ImproverX/PK-6128c_PP/README.md

# Вектор ПК-6128ц++
Вектор ПК-6128ц новодел на базе [восстановленной схемы](https://github.com/ImproverX/PK-6128c). Электронная часть выполнена на трёх платах: процессора, памяти и основной платы, соединяющихся между собой через угловые двухрядные штырьевые разъёмы. Предусмотрена установка двух внутренних плат расширения, например, [квази-дисков](/KVAZI_DISK/). Платы выполнены в размере под установку в обычный [корпус ПК Вектор-06ц](https://github.com/ImproverX/Vector06c_case), в качестве клавиатуры используется [плата под ПКМ-1Б или кнопки Черри](https://github.com/ImproverX/Vector-KBD), либо оригинальная клавиатура от Вектора, блок питания -- внешний от Вектора, либо любой на 5В и 1А (минимум).<br>Обсуждение в [форуме zx-pk.ru](https://zx-pk.ru/threads/34716-reinkarnatsiya-vektor-pk-6128ts.html).

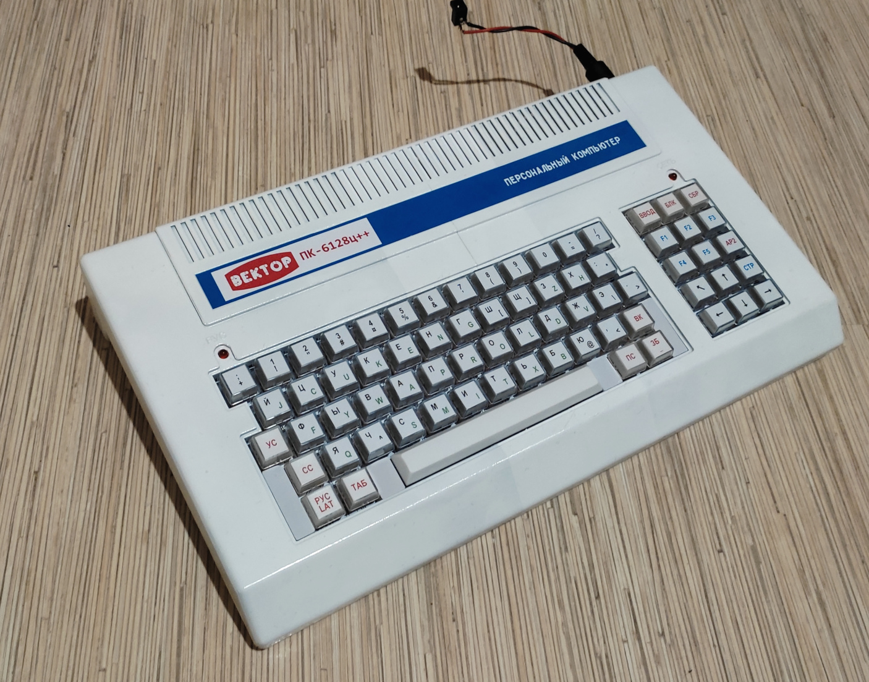
[picture p1: Photo.jpg]
P0


## Содержимое проекта
* [PK6128c_PP.DSN](/PK6128c_PP.DSN) -- обновлённая схема ПК-6128ц++ в формате Proteus 7. В данном ПО возможно частичное моделирование работы схемы. Для корректного открытия схемы потребуется содержимое ПЗУ D10 (К155РЕ3) в бинарном виде [K155RE3.bin](/K155PE3.bin) и модель [K155RE3.MDF](https://github.com/ImproverX/PK-6128c/blob/main/K155PE3.MDF) (положите этот файл в "<директория протеуса>\MODELS" для работы моделирования D10 в схеме).
* [PK6128c_PP.LYT](/PK6128c_PP.LYT) -- разводка плат в формате Proteus 7.
* [PK6128c_PP_Shema_P1.png](/PK6128c_PP_Shema_P1.png) и [PK6128c_PP_Shema_P2.png](/PK6128c_PP_Shema_P2.png) -- схема в формате PNG, страница 1 и страница 2.
* [PK6128c_PP_cpu - CADCAM.ZIP](/PK6128c_PP_cpu%20-%20CADCAM.ZIP), [PK6128c_PP_ram - CADCAM.ZIP](/PK6128c_PP_ram%20-%20CADCAM.ZIP) и [PK6128c_PP_main - CADCAM.ZIP](/PK6128c_PP_main%20-%20CADCAM.ZIP) -- гербер-архивы для изготовления плат процессора, памяти и основной платы соответственно.
* [K155RE3n.bin](/K155PE3n.bin) -- прошивка для ПЗУ D10, оптимизированная для ПК-6128ц++, с постоянным округлением команд до кратности 4 тактам (рекомендуется). [K155RE3.bin](/K155PE3.bin) -- та же прошивка, но с кратностью "2 такта" торможения работы процессора при выводе бордюра и КСИ/ССИ, даёт небольшое ускорение, но возможны глюки. Оба варианта описаны в файле [K155PE3.txt](/K155PE3.txt).
* [ROM](/ROM/) -- прошивка для ПК-6128ц++.
* [Joysticks.png](/Joysticks.png) -- подключение джойстиков.
* [KVAZI_DISK](/KVAZI_DISK/) -- внутренний квази-диск для ПК-6128ц++ на 512кБ (2х256кБ), совместим с МДОС, в том числе [Т-72](https://github.com/ImproverX/MDOS_T-72) и [РДС](https://github.com/ImproverX/RDS), работает на портах 10h и 11h. Схема, разводка и гербер-архив для изготовления платы.
* [HDD](/HDD/) -- внутренний контроллер накопителя на жёстких магнитных дисках (НЖМД, или HDD), программно совместим с МДОС и РДС. В качестве НЖМД могут использоваться различные SSD-IDE диски (например, DiskOnModule), а также переходники на CF и CD-карты. Также отдельно разведена плата с разъёмом для CF-карт вместо IDE.

Нумерация элементов оригинального ПК-6128ц по возможности сохранена, добавленные микросхемы на схеме обозначены U**, резисторы от R200 и далее, конденсаторы от C100 и далее.

## Примечания по сборке ПК-6128ц++

Резисторы R3 и R216 возможно потребуется подобрать под кварц для стабильной генерации частоты, их номинал может варироваться от 500 Ом до 4,8 кОм, следует выбирать среднее значение.

В случае установки YM2149F вместо AY-3-8910 резистор R223 следует увеличить до 8,2 кОм для выравнивания громкости с ВИ53.

Дроссель L1 нужно выбирать на ток не меньше 800 мА.

Кварц Q2 (4,433619 МГц) следует выбирать с максимальной доступной точностью, иначе возможны пропадания цвета при передаче сигнала PAL.

Кварц Q3 (7,0936 МГц или 3,5468 МГц) можно заменить близким по номиналу, +/- 100кГц. Но при этом следует учесть, что тональность звука на AY-3-8910 будет пропорционально выше или ниже. Например, при установке кварца на 7,1 МГц нота ЛЯ вместо 440 Гц будет звучать на 440,4 Гц (+0,09%).

Кварц Q4 (32,768 кГц) следует выбирать с характеристикой нагрузочной емкости 6 пФ, иначе точность часов будет неудовлетворительной.

В остальном, при исправных деталях и качественной пайке, ПК-6128ц++ в настройке не нуждается и начинает работать сразу.

## Изменения по отношению к оригинальной схеме ПК-6128ц

* Заменил память на SRAM. Сейчас это сделать проще, чем искать РУ5. Память осталась на 16 бит при чтении видеоданных с задержкой на триггере, как было сделано изначально в ПК-6128. 
* Заменил ПЗУ РФ4А на 64кб 29EE512. Переключение доступа к страницам ПЗУ программное, для этого используется стандартная переключалка области экрана ПК-6128 на порту 0Dh. При отправленном нуле в нулевом бите в этот порт будет подключена область ПЗУ 8000h-FFFFh (по умолчанию при сбросе), при единице -- область 0000h-7FFFh.
* Убрал из схемы сетевую карту. Как оказалось, в некоторых экземплярах ПК-6128ц она не была распаяна, да и в современных реалиях она становится совершенно бесполезной. 
* Убрал контроллер дисковода -- при внешнем подключении не имеет значения, есть ли в ПК встроенный контроллер, если он подключается вместе с флоповодом.
* Заменил все чипы КМОП серий К561 и К1561 на ТТЛ. Кроме того это позволило убрать из схемы несколько резисторов и конденсаторов, требующихся для совмещения уровней сигналов КМОП и ТТЛ.
* Сделал видеовыход на CXA2075, в том числе:
  * Сделал инверсию цвета, исправил строчные синхроимпульсы (ССИ) и выровнял по центру изображение.
  * Немного изменил схему формирования сигнала кадровых синхроимпульсов (КСИ) -- вместо объединения КСИ и ССИ через "исключающее или" использовал свободный триггер.
  * Сделал гасящий синхроимпульс (ГСИ), во время кадра он на ~5мкс длиннее ССИ, и на всю длительность КСИ гасит сигнал.
  * Заменил резисторный видео-ЦАП на чип SDA7123, что существенно улучшило качество картинки.
* Изменил схему записи палитры -- в схеме ПК6128 микросхемы РУ2 были открыты всегда, кроме некоторого времени перед КСИ и в конце КСИ. Теперь РУ2, при отсутствии сигнала записи в порт 0Ch, будут отключаться при ГСИ. Кроме того, при нажатии на БЛК-СБР теперь экран не засвечивается белым, как было на ПК-6128ц, а гасится.
* Исправил схему работы экрана в режиме 256х512, теоретически получается так: по даташитам задержка на 74ALS00 (D14:A) равна 3..11 (2..8) нс, на 74ALS32 (U10:C) -- 2..14 (3..12) нс, т.е. разница при худшем варианте характеристик деталей должна быть не больше 5 нс при ширине пикселя 83 нс в режиме 512. На реале разница практически не заметна.
* Изменил схему подключения джойстиков -- на ПК6128 был свой вариант, программно несовместимый с существующими на Векторе. Сделал также, как на "Векторе-06ц.02", плюс аппаратно совместимыми с [джойстиками Atari/MSX](https://www.msx.org/wiki/Joystick/joypad_controller), на разъёмах D9 (как com-порт). Есть возможность использовать [джойстики от Sega](https://eax.me/arduino-sega-controller/) (только указатель направления и кнопки В и С). Для подключения к плате используется стандартный провод для COM-порта, подробнее -- [см. тут](/Joysticks.png).
* Добавил в схему стандартный Векторовский порт ВУ -- с ним можно будет подключать существующее внешнее Векторовское железо, например, тот же комбодевайс. Сигнал СТЕК там формируется по типу адаптеров Z80 для Вектора, он будет подан при командах PUSH, POP и XTHL, чего вполне достаточно для работы КД. Единственно, на этом ВУ не будут работать старые квази-диски, т.к. новая схема не вырабатывает сигналы регенерации памяти.
* Добавил внутренний динамик и AY-3-8910. Выход AY подключён по методу Саттарова В., но только микшируется в моно.
* Добавил часы RTC на DS12885, подключение выполнено по [омской схеме](https://caglrc.cc/scalar/ware/519/) для Вектора, с учётом документации на DS12885.
* D25 заменил на 74HC138 и U24 на 74hc139 -- чипы 74HC155 и аналогичные в исполнении SMD почему-то сложно найти в продаже.
* Разделил схему на платы в соответствии с предложенной [концепцией](https://zx-pk.ru/threads/34546-quot-vektor-pk-6128ts-quot-khotelos-by-uznat-pobolshe.html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). Элементы на схеме с фоном из жёлтой штриховки ушли на плату ОЗУ, с голубой штриховкой -- ЦПУ.
* Для сокращения числа контактов между платами внедрил одну из своих прошлых идей, сделал "эмуляцию" ВВ55 на логических элементах U28 и U29, что позволило сократить число линий на 8+5-3=10 шт. И теперь независимо от того, какая конфигурация загружена в ВВ55 на порту 00, запись в порт 03 будет устанавливать сдвиг экрана, запись в порт 02 -- цвет бордюра и режим 512/256. В дополнение, для полного соответствия работе ВВ55, запись в порт 00 конфигурации приводит к обнулению значений в портах 02 и 03, для выключения обнуления портов можно разомкнуть перемычку JP2.
* Решил использовать ПЗУ D10 на все 100%, для этого вывод А4 переключил с земли на сигнал LD0, теперь во время показа бордюров и КСИ/ССИ из неё будет использоваться вторая половина адресов, с 16 по 31. Это даёт то, что теперь можно будет разрешить процессору доступ к памяти тогда, когда не считываются данные для графики. Прирост быстродействия при этом будет максимум процентов на 5, если не ошибаюсь, но при этом будет неравномерная скорость процессора, что в некоторой степени влияет на обмен с магнитофоном, а также на другие процедуры, зависимые от времени выполнения команд процессора. Для обеспечения равномерной скорости ЦПУ рекомендуется использовать прошивку [K155RE3n.bin](/K155PE3n.bin).
* Добавил подтягивающие резисторы на шину данных -- теперь при чтении из неподключённых портов возвращается код FFh.

## Порты внутренних устройств ПК-6128ц++

* 00..03 -- Управление D80 (ВВ55А): клавиатура, режимы экрана, магнитофон.
* 04..07 -- Порт ПУ D78 (ВВ55А)
* 08..0B -- Таймер D79 (ВИ53)
* 0C -- Запись цвета в D54, D55 (РУ2)
* 0D -- Установка номера банка ОЗУ для экрана
* 0E -- Установка режимов диспетчера памяти / Чтение состояния Джойстика 2
* 0F -- Сброс системы / Чтение состояния джойстика 1
* 10 -- Запись конфигурации Квази-Диска 1
* 11 -- Запись конфигурации Квази-Диска 2
* 12, 13 -- (не используется)
* 14, 15 -- Управление синтезатором U22 (AY-3-8910)
* 16..1F -- (не используется)
* 20, 21 -- Управление часами U34 (DS12885S)
* 22..4F -- (не используется)
* 50..58, 5F -- контроллер НЖМД (IDE HDD)
* 59..5E, 60..FF -- (не используется)

## ...

Фотография внутренностей собранного ПК-6128ц++:<br>
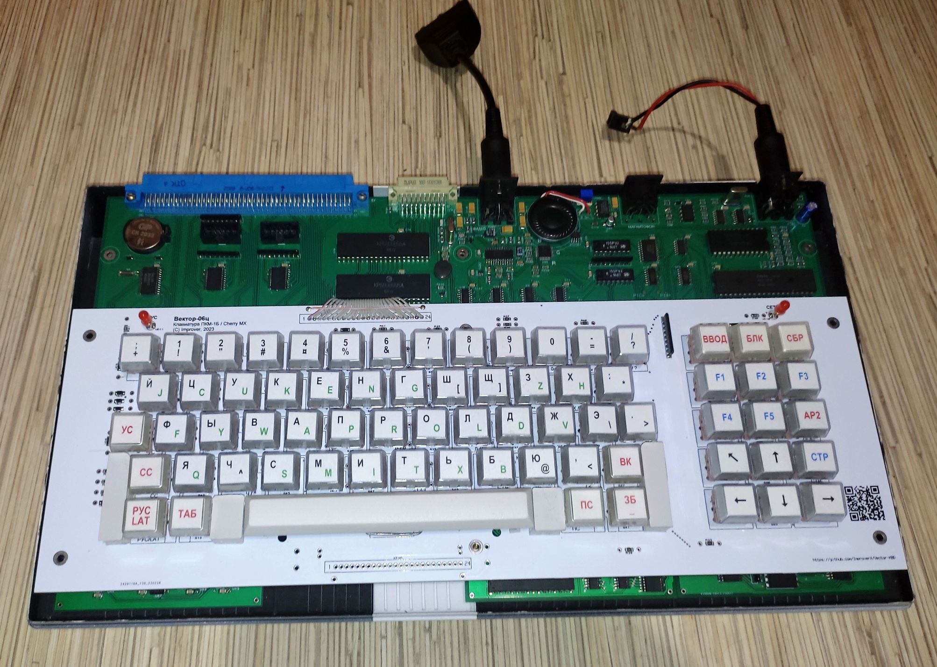
[picture p2: Photo1.jpg]
P3
<br><br>
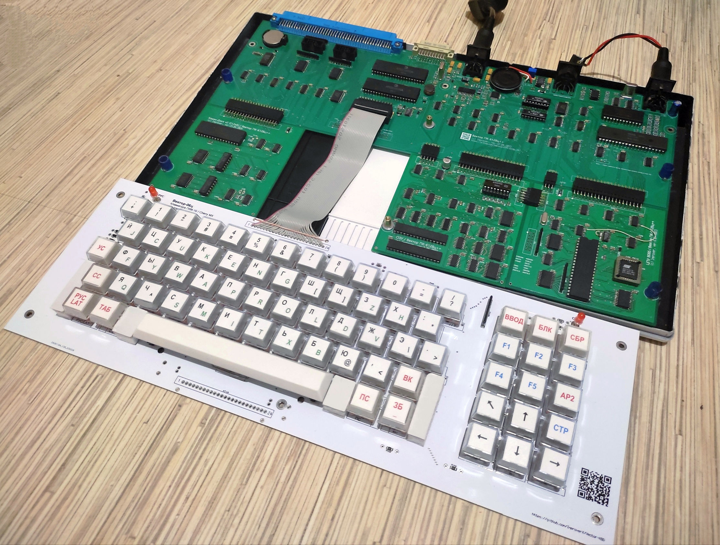
[picture p3: Photo2.jpg]
P4
<br><br>

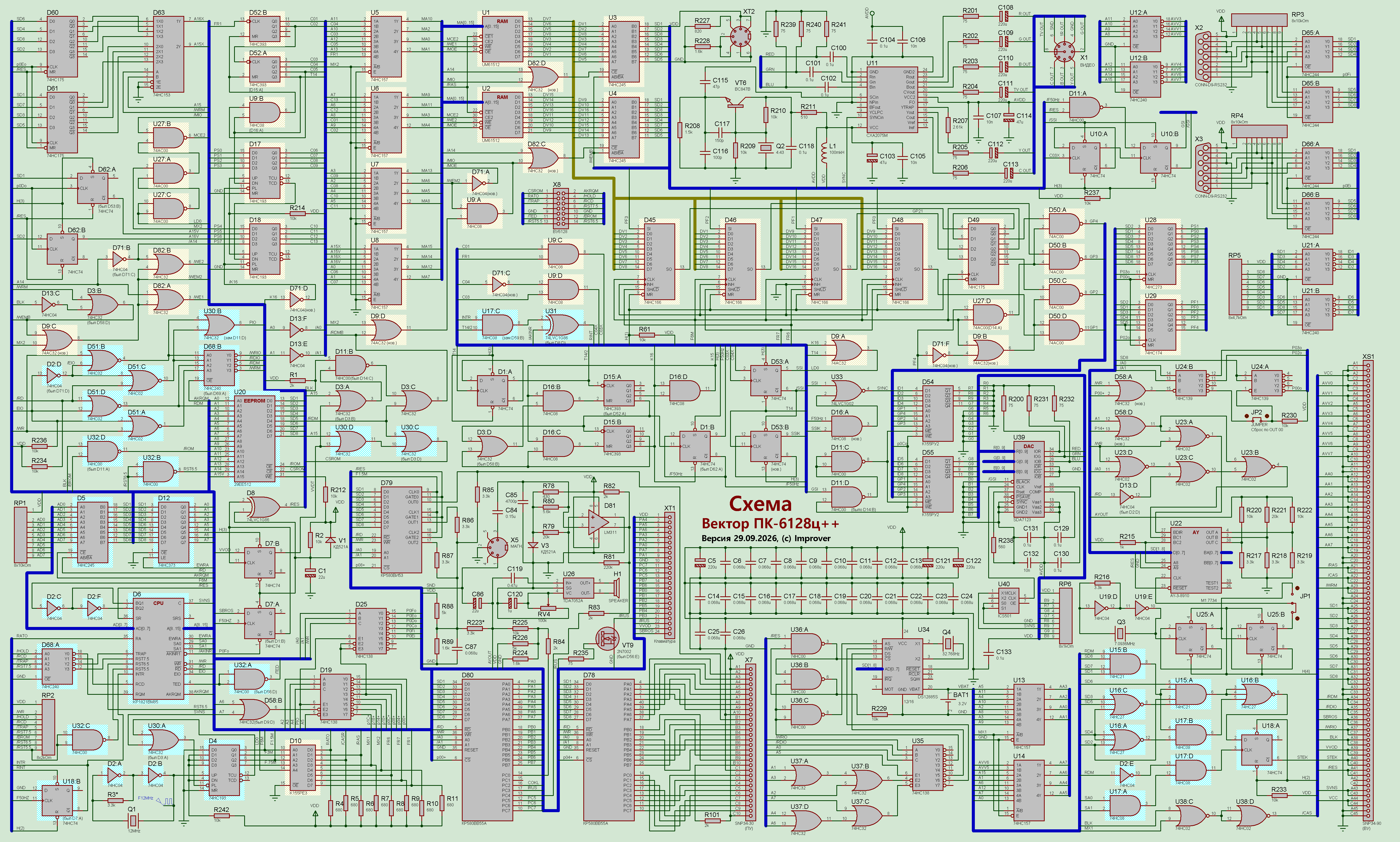
[picture p4: PK6128c_PP_Shema_P1.png]
P1
<br>
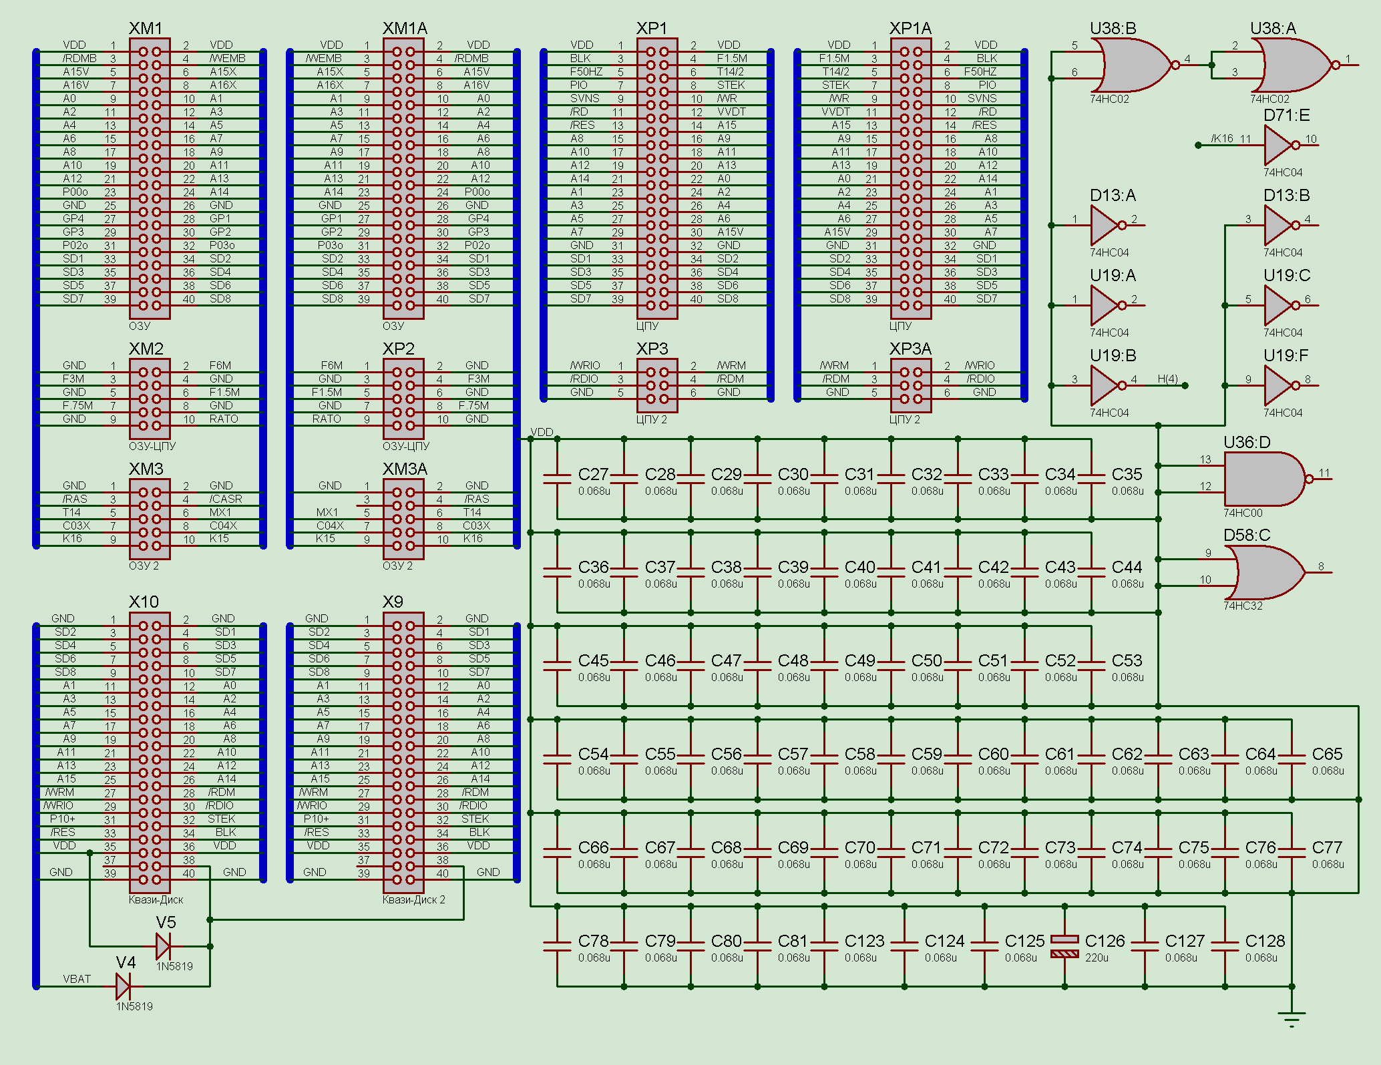
[picture p5: PK6128c_PP_Shema_P2.png]
P2
