ImproverX/PK-6128c_PP/GAL-RE3/README.md

# Замена К155РЕ3 на GAL16V8B

На место D10 (К155РЕ3) можно установить GAL16V8B. Схема подключения и фото установки:

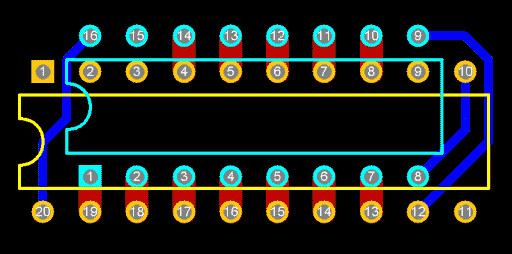
[picture p6: GAL-RE3/GAL2RE3.png]
P1


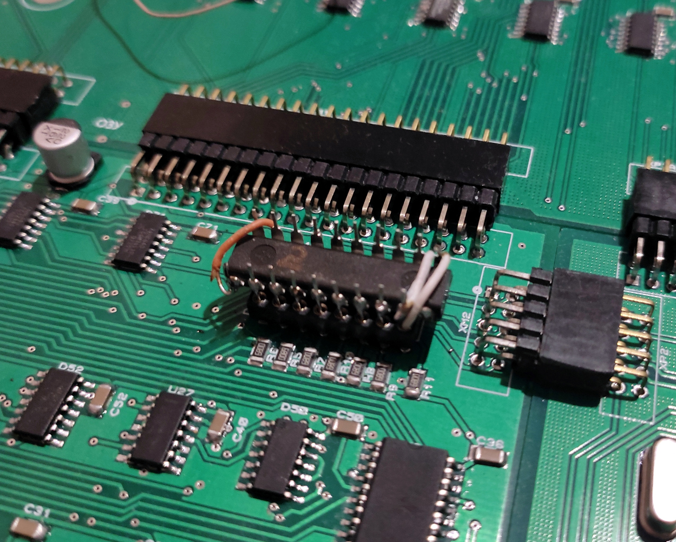
[picture p7: GAL-RE3/GAL2RE3.jpg]
P2


## Прошивка
* [RE3_N.jed](/GAL-RE3/RE3_N.jed) -- обычный режим работы памяти, исходники [RE3_N.pld](/GAL-RE3/RE3_N.PLD) и [RE3_N.si](/GAL-RE3/RE3_N.SI)
* [RE3__.jed](/GAL-RE3/RE3__.jed) -- ускоренный режим работы памяти, исходники [RE3__.pld](/GAL-RE3/RE3__.PLD) и [RE3__.si](/GAL-RE3/RE3__.SI)
