ImproverX/PK-6128c_PP/HDD/README.md

# Контроллер НЖМД для ПК-6128ц++

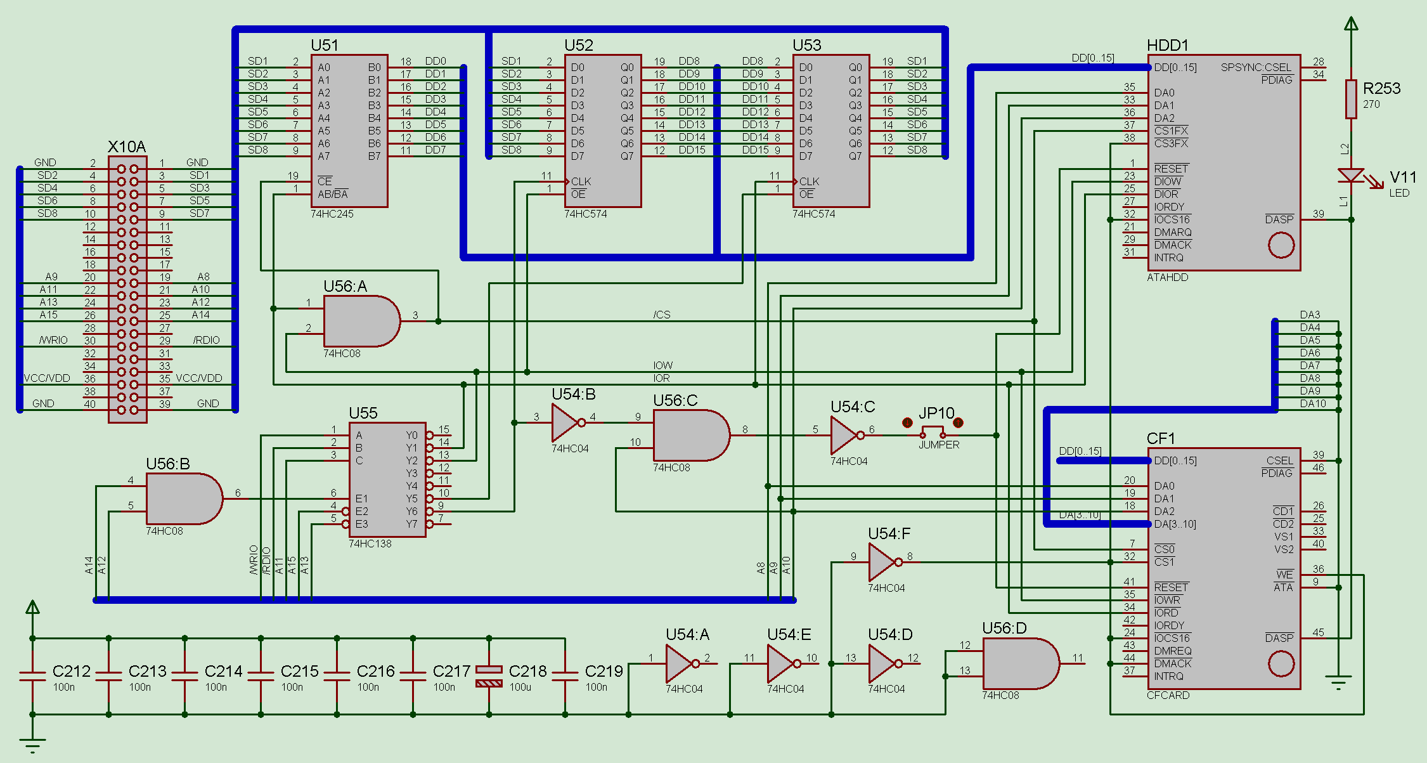
[picture p9: HDD/hdd_6128pp.png]
P1
