ImproverX/PK-6128c_PP/KVAZI_DISK/README.md

# Квази-диск для ПК-6128ц++

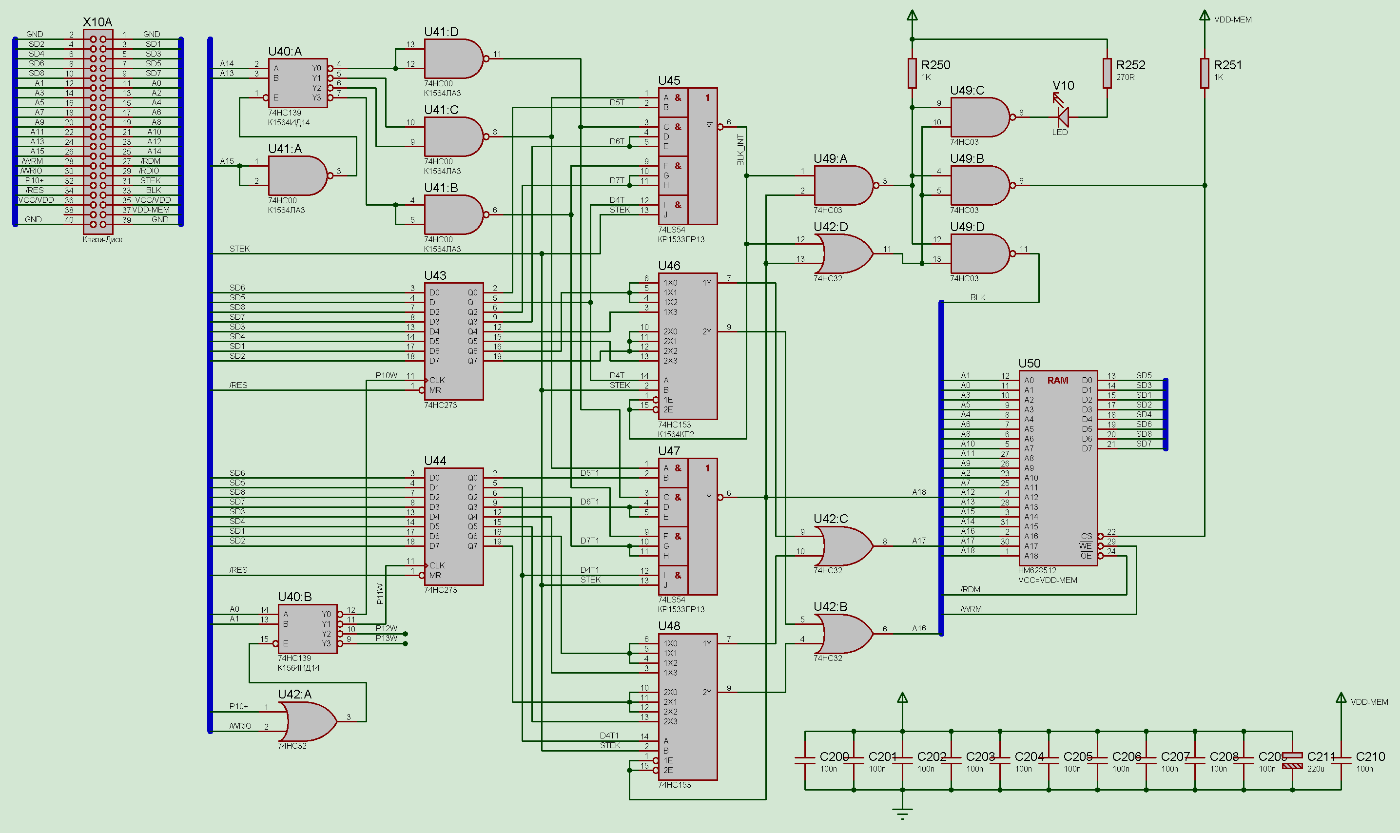
[picture p10: KVAZI_DISK/kd_6128pp.png]
P1
