ImproverX/PK-6128c_PP/HDD/HDD_CF.jpg

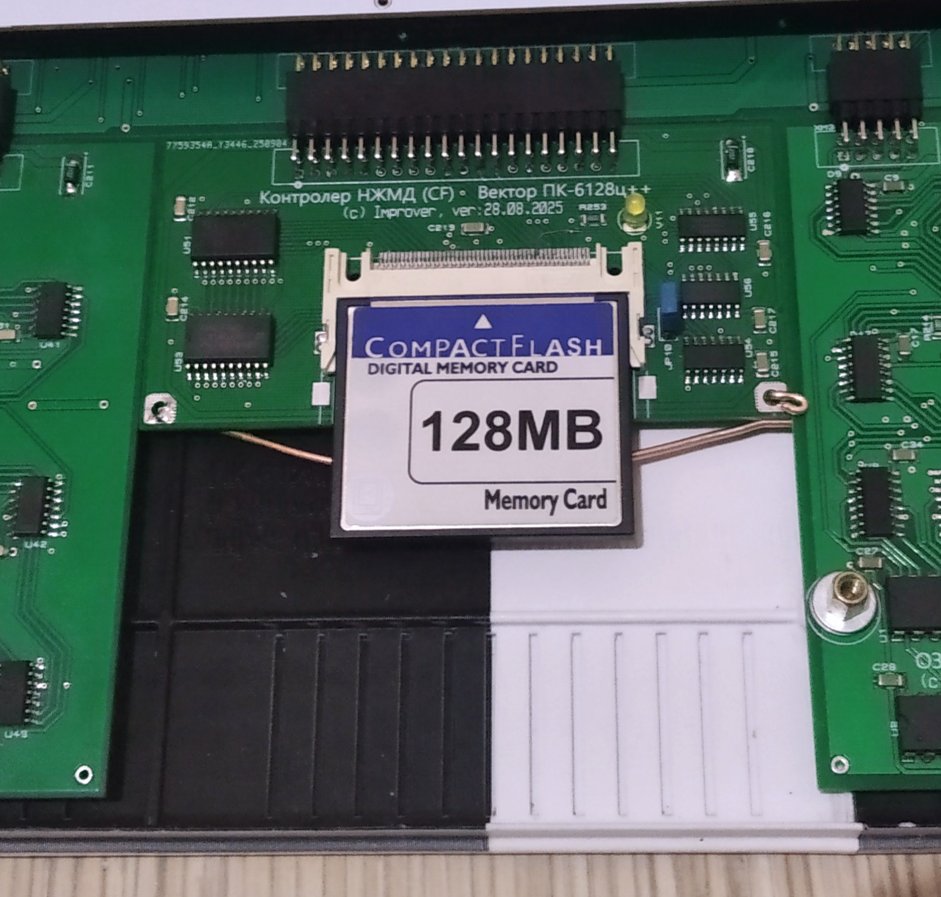
HDD/HDD_CF.jpg
