ImproverX/PK-6128c_PP/HDD/HDD_DOM.jpg

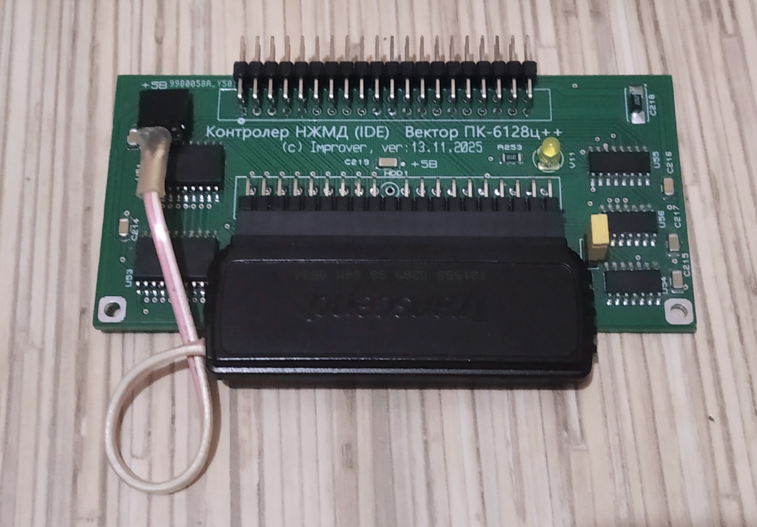
HDD/HDD_DOM.jpg
