ImproverX/PK-6128c_PP/Joysticks.png

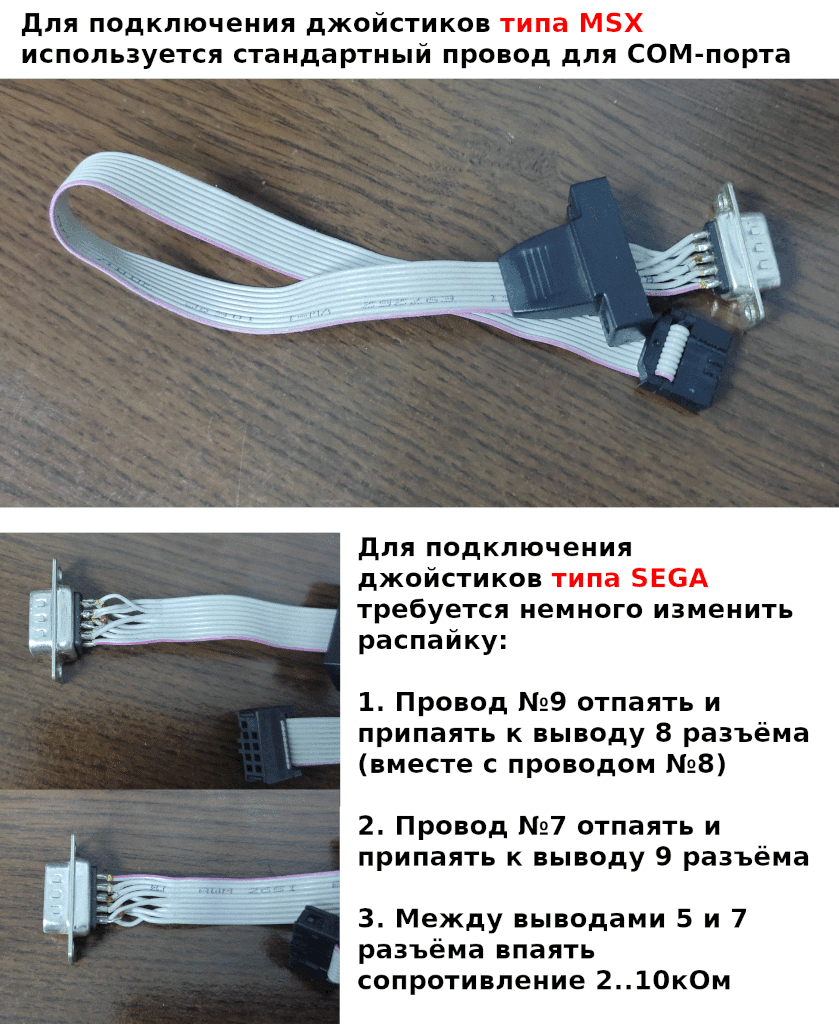
Joysticks.png
