ImproverX/PK-6128c_PP/KVAZI_DISK/KD.jpg

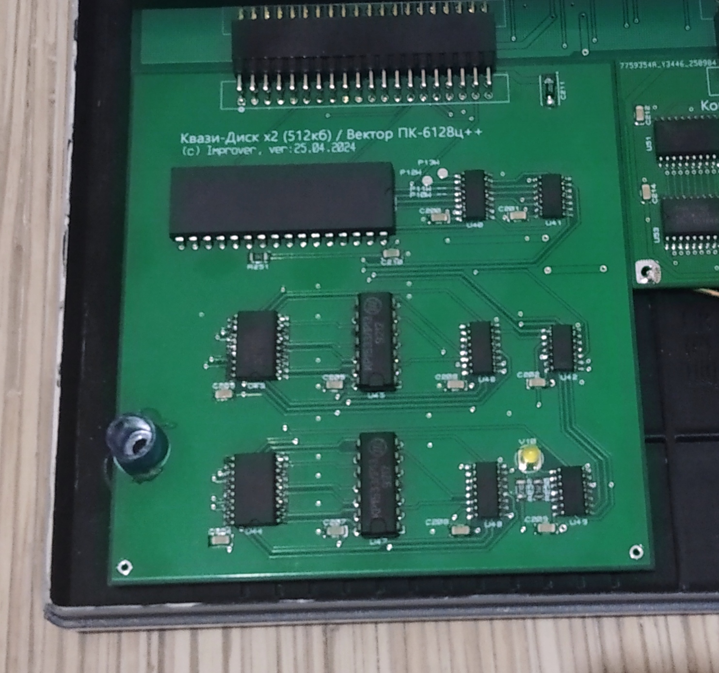
KVAZI_DISK/KD.jpg
