ImproverX/PK-6128c_PP/(list of files, drawings)

Other design files:
HDD/hdd_6128pp.DSN
HDD/hdd_6128pp.LYT
HDD/hdd_6128pp_CF.LYT
KVAZI_DISK/kd_6128pp.DSN
KVAZI_DISK/kd_6128pp.LYT
PK6128c_PP.DSN
PK6128c_PP.LYT
T2RAM/T2RAM_PK6128c.DSN
T2RAM/T2RAM_PK6128c.LYT
